fitu/CAD_TEST2/cad/cost_estimate.csv

item | quantity | unit_low_ILS | unit_high_ILS | total_low_ILS | total_high_ILS | note
bench_clamp_100mm | 2 | 25 | 55 | 50 | 110
bolt_M4x16 | 2 | 0.5 | 1.5 | 1.0 | 3.0
bolt_M4x20 | 2 | 0.5 | 1.5 | 1.0 | 3.0
bolt_M4x25 | 2 | 0.5 | 1.5 | 1.0 | 3.0
bolt_M5x20 | 8 | 0.6 | 2 | 4.8 | 16
bolt_M5x25 | 4 | 0.6 | 2 | 2.4 | 8
bolt_M5x40 | 2 | 0.6 | 2 | 1.2 | 4
bolt_M5x50 | 4 | 0.6 | 2 | 2.4 | 8
bolt_M6x30 | 2 | 0.8 | 2.5 | 1.6 | 5.0
bolt_M6x45 | 2 | 0.8 | 2.5 | 1.6 | 5.0
bolt_M8x25 | 1 | 1.5 | 4 | 1.5 | 4
firm_backing_and_protective_pads_set | 1 | 10 | 25 | 10 | 25
ground_dowel_6x30 | 2 | 3 | 10 | 6 | 20
ground_shaft_8x400 | 1 | 30 | 70 | 30 | 70
nut_M4 | 12 | 0.2 | 0.8 | 2.4 | 9.6
nut_M5 | 20 | 0.2 | 0.8 | 4.0 | 16.0
nut_M6 | 9 | 0.2 | 0.8 | 1.8 | 7.2
nut_M8 | 1 | 0.2 | 0.8 | 0.2 | 0.8
nylon_tip_screw_M4x8 | 4 | 2 | 6 | 8 | 24
set_screw_M4x16 | 2 | 0.6 | 2 | 1.2 | 4
stone_60x180x30 | 1 | 60 | 180 | 60 | 180 | optional if already owned
thin_nonmarring_blade_tape | 1 | 5 | 12 | 5 | 12
threaded_rod_M6x160_cut_from_stock | 1 | 8 | 20 | 8 | 20
washer_M4 | 2 | 0.1 | 0.5 | 0.2 | 1.0
washer_M5 | 8 | 0.1 | 0.5 | 0.8 | 4.0
washer_M6 | 10 | 0.1 | 0.5 | 1.0 | 5.0
washer_M8 | 2 | 0.1 | 0.5 | 0.2 | 1.0
spare_fasteners_and_pack_size_allowance | 1 | 10 | 25 | 10 | 25 | budget allowance
PETG_1kg_spool | 2 | 70 | 120 | 140 | 240 | whole spools; includes unused filament
