fitu/CAD_TEST2/cad/purchase_bom.csv

item | quantity
bench_clamp_100mm | 2
bolt_M4x16 | 2
bolt_M4x20 | 2
bolt_M4x25 | 2
bolt_M5x20 | 8
bolt_M5x25 | 4
bolt_M5x40 | 2
bolt_M5x50 | 4
bolt_M6x30 | 2
bolt_M6x45 | 2
bolt_M8x25 | 1
firm_backing_and_protective_pads_set | 1
ground_dowel_6x30 | 2
ground_shaft_8x400 | 1
nut_M4 | 12
nut_M5 | 20
nut_M6 | 9
nut_M8 | 1
nylon_tip_screw_M4x8 | 4
set_screw_M4x16 | 2
stone_60x180x30 | 1
thin_nonmarring_blade_tape | 1
threaded_rod_M6x160_cut_from_stock | 1
washer_M4 | 2
washer_M5 | 8
washer_M6 | 10
washer_M8 | 2
