fitu/CAD_TEST2/sharpener_assembly.step

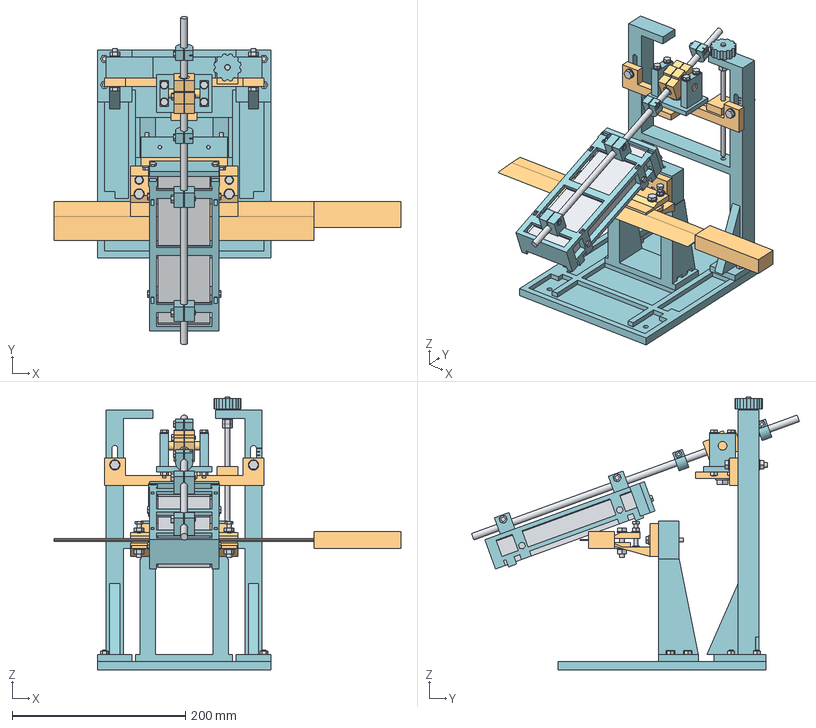
[picture p3: CAD file, 2026-11-03]
sharpener_assembly.step
400.0 x 378.6 x 315.0 mm
01_ribbed_bench_base
02_open_portal_frame
18_fine_height_knob
03_fixed_cartridge_dock
04_removable_knife_cartridge
05_upper_knife_jaw
06_blade_shim_3mm
REF_blade_envelope
REF_handle_envelope
05_height_carriage
06_yaw_plate
07_pitch_cheek_1
07_pitch_cheek_2
08_pitch_housing
09_calibrated_guide_sleeve
15_split_rod_stop_1
15_split_rod_stop_2
13_ribbed_stone_cassette
14_removable_end_gate
REF_whetstone
REF_stone_backing_1
REF_stone_backing_2
REF_stone_backing_3
REF_end_pad_fixed
REF_end_pad_gate
REF_side_pad_1
REF_side_pad_2
REF_side_pad_3
REF_side_pad_4
REF_guide_rod_8x400
HW_bolt_M5x20_1
HW_nut_M5_1
HW_bolt_M5x20_2
HW_nut_M5_2
HW_bolt_M5x20_3
HW_nut_M5_3
HW_bolt_M5x20_4
HW_nut_M5_4
HW_threaded_rod_M6x160_cut_from_stock_1
HW_nut_M6_1
HW_nut_M6_2
HW_washer_M6_1
HW_washer_M6_2
HW_nut_M6_3
HW_nut_M6_4
HW_bolt_M5x20_5
HW_nut_M5_5
HW_bolt_M5x20_6
HW_nut_M5_6
HW_bolt_M5x20_7
HW_nut_M5_7
HW_bolt_M5x20_8
HW_nut_M5_8
HW_ground_dowel_6x30_1
HW_set_screw_M4x16_1
HW_nut_M4_1
HW_ground_dowel_6x30_2
HW_set_screw_M4x16_2
HW_nut_M4_2
HW_bolt_M5x40_1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
