fitu/CAD_TEST2/parts/03_fixed_cartridge_dock.step

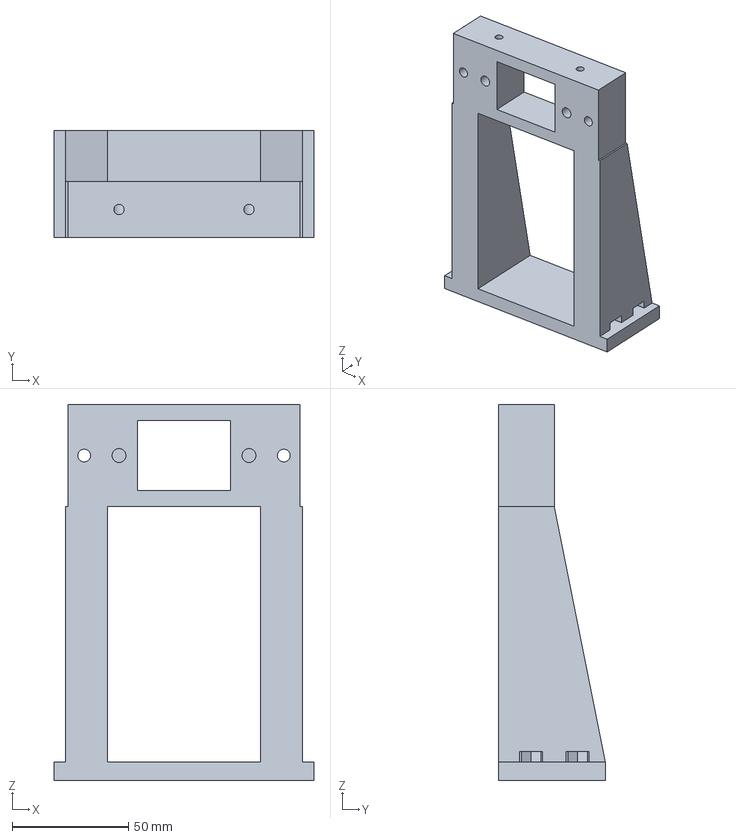
[picture p4: CAD file, 2026-11-03]
parts/03_fixed_cartridge_dock.step
112.0 x 46.0 x 162.0 mm
