fitu/CAD_TEST2/parts/05_height_carriage.step

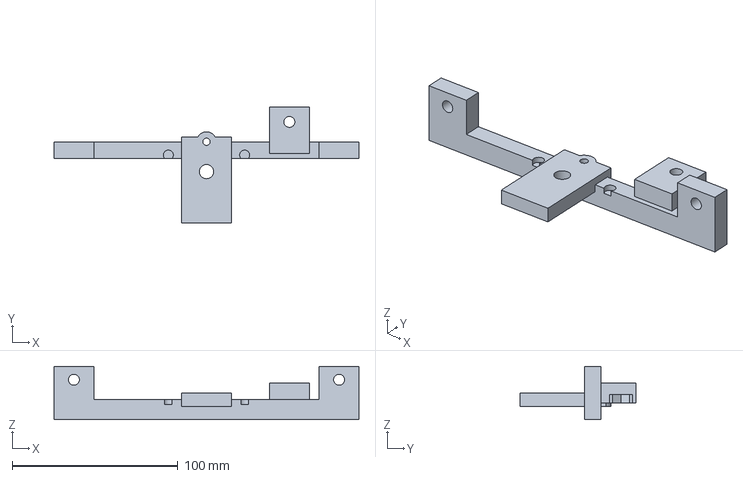
[picture p5: CAD file, 2026-11-03]
parts/05_height_carriage.step
184.0 x 70.0 x 32.0 mm
