fitu/CAD_TEST2/parts/REF_whetstone.step

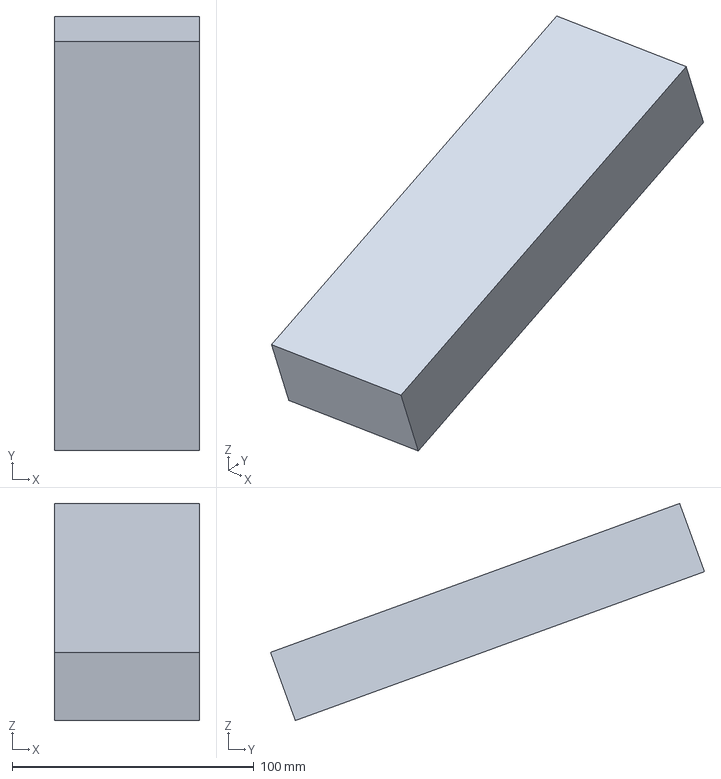
[picture p6: CAD file, 2026-11-03]
parts/REF_whetstone.step
60.0 x 179.4 x 89.8 mm
