fitu/CAD_TEST2/parts/REF_side_pad_2.step

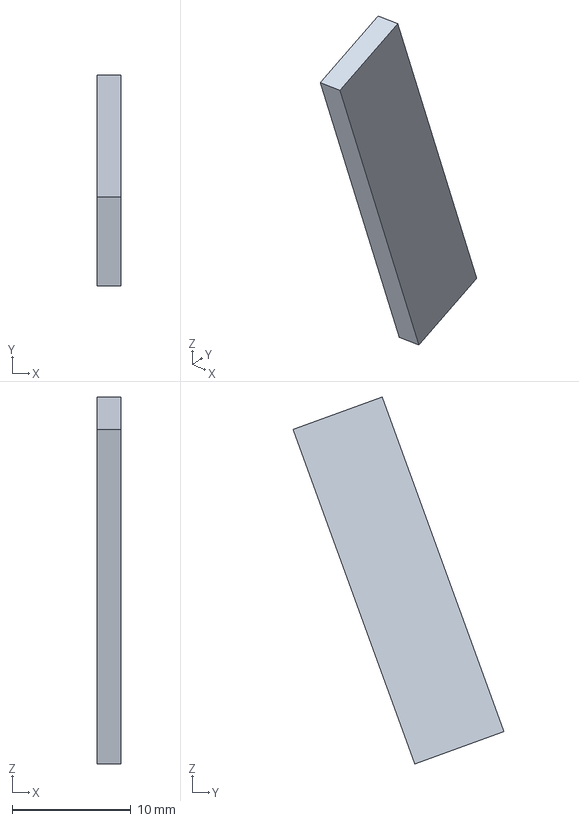
[picture p7: CAD file, 2026-11-03]
parts/REF_side_pad_2.step
2.00 x 17.8 x 30.9 mm
