fitu/CAD_TEST2/parts/07_pitch_cheek_1.step

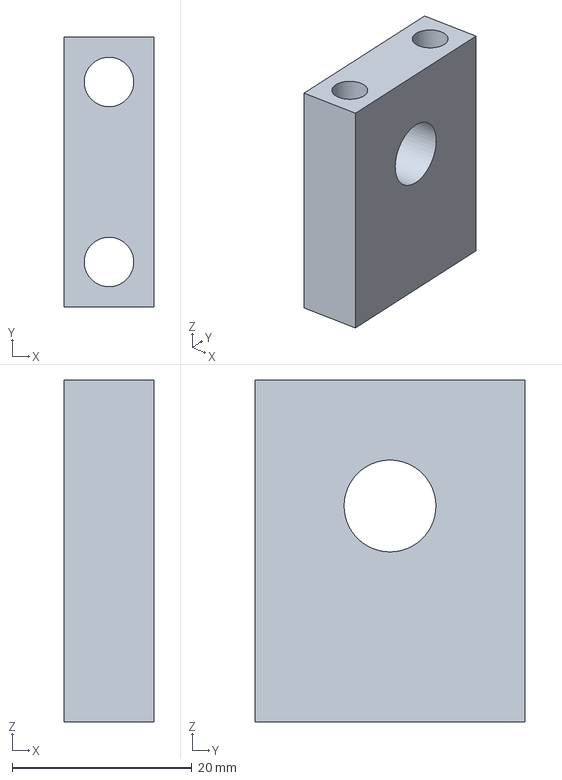
[picture p8: CAD file, 2026-11-03]
parts/07_pitch_cheek_1.step
10.0 x 30.0 x 38.0 mm
