fitu/CAD_TEST2/parts/15_split_rod_stop_2.step

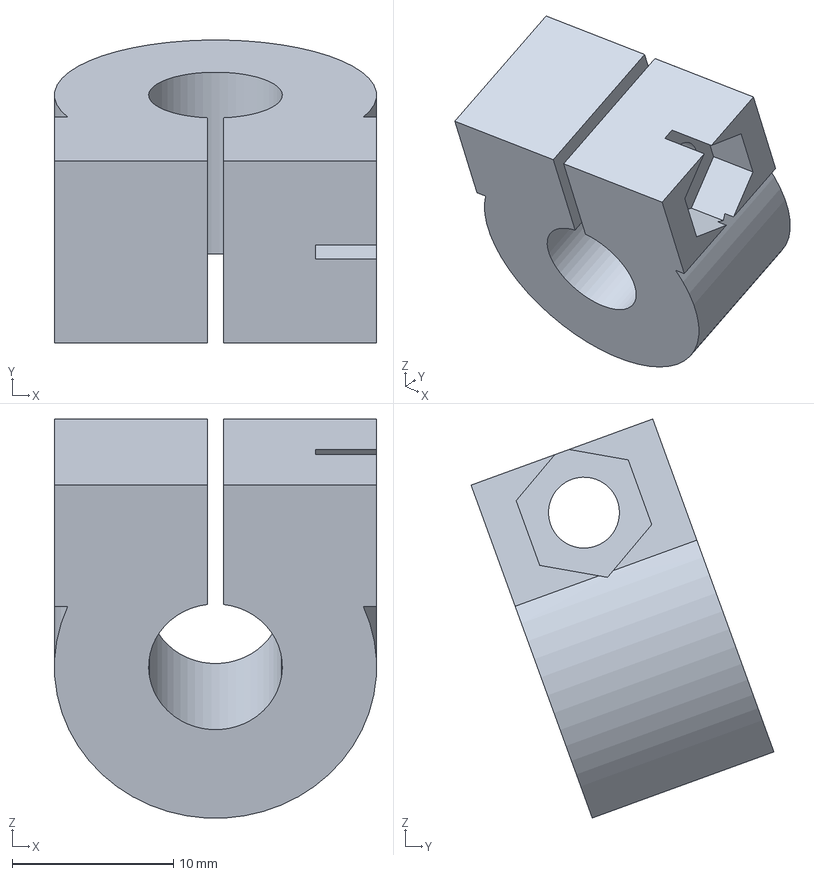
[picture p9: CAD file, 2026-11-03]
parts/15_split_rod_stop_2.step
20.0 x 18.8 x 24.8 mm
