fitu/CAD_TEST2/parts/REF_stone_backing_1.step

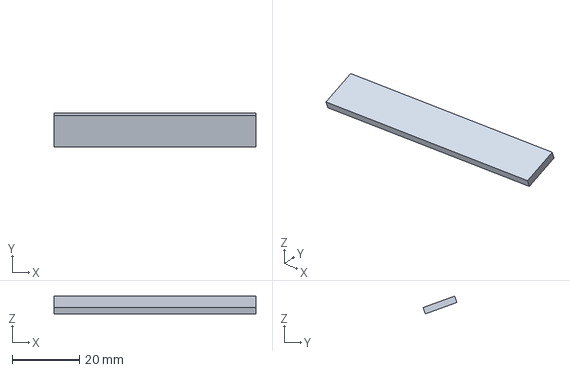
[picture p10: CAD file, 2026-11-03]
parts/REF_stone_backing_1.step
60.0 x 10.1 x 5.30 mm
