fitu/CAD_TEST2/parts/REF_end_pad_fixed.step

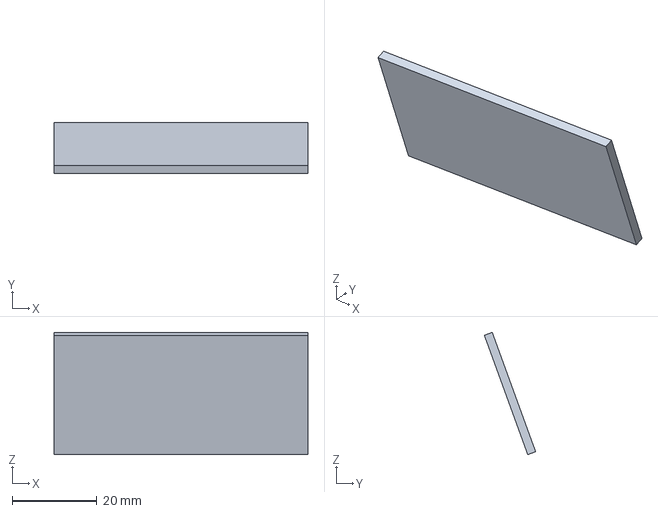
[picture p11: CAD file, 2026-11-03]
parts/REF_end_pad_fixed.step
60.0 x 12.1 x 28.9 mm
