fitu/CAD_TEST2/hardware/shaft_M6x160.step

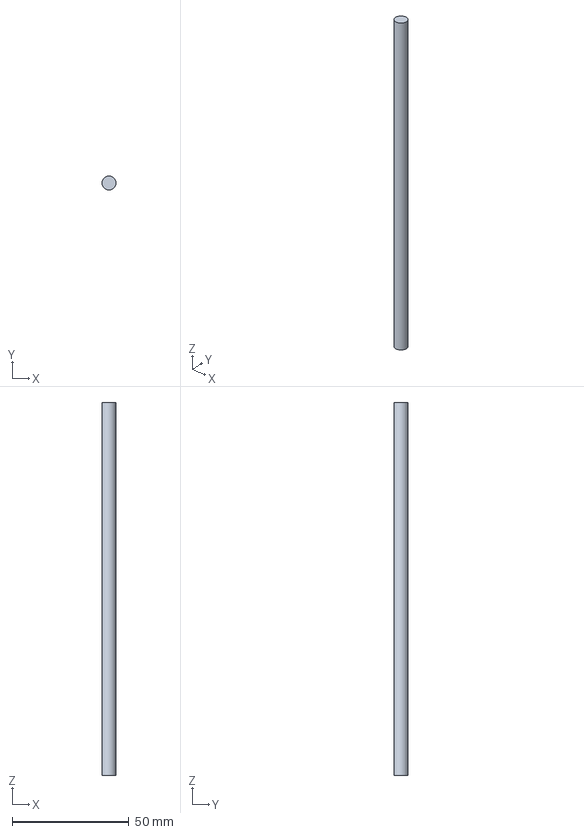
[picture p12: CAD file, 2026-11-03]
hardware/shaft_M6x160.step
5.99 x 6.00 x 160.0 mm
