fitu/CAD_TEST2/parts/OPTION_blade_shim_for_4mm.step

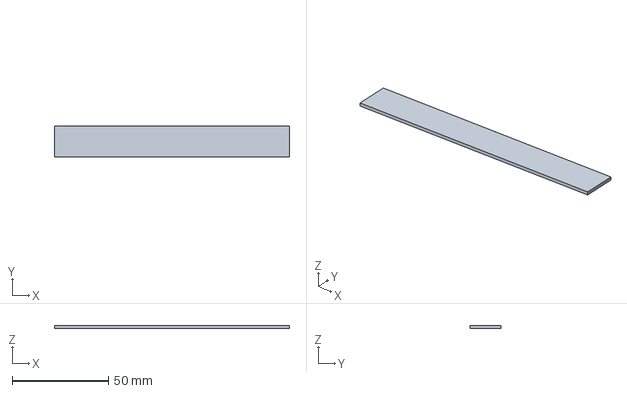
[picture p13: CAD file, 2026-11-03]
parts/OPTION_blade_shim_for_4mm.step
122.0 x 16.0 x 1.50 mm
