fitu/CAD_TEST2/parts/02_open_portal_frame.step

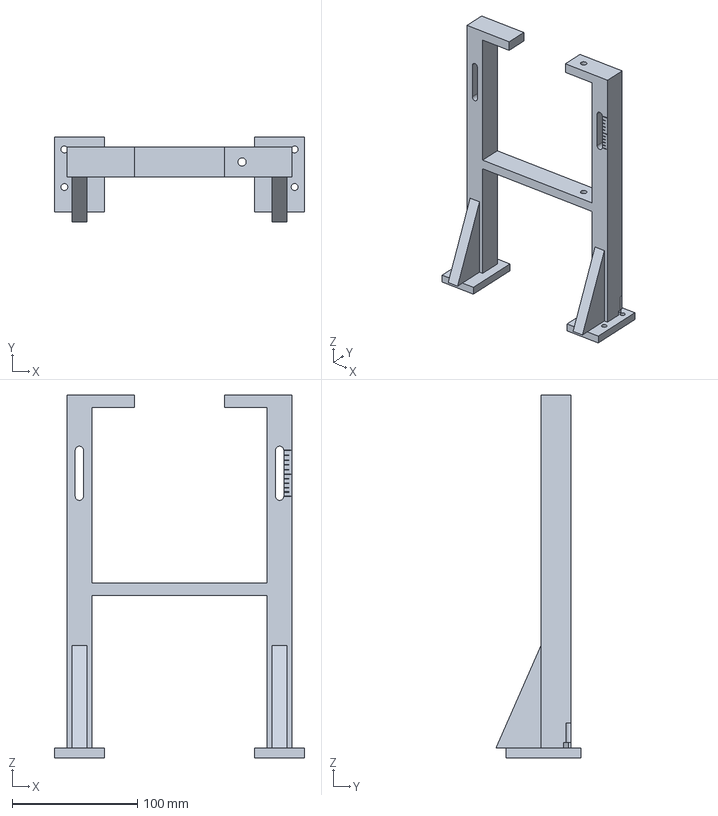
[picture p14: CAD file, 2026-11-03]
parts/02_open_portal_frame.step
200.0 x 68.0 x 290.0 mm
