fitu/CAD_TEST2/parts/06_blade_shim_3mm.step

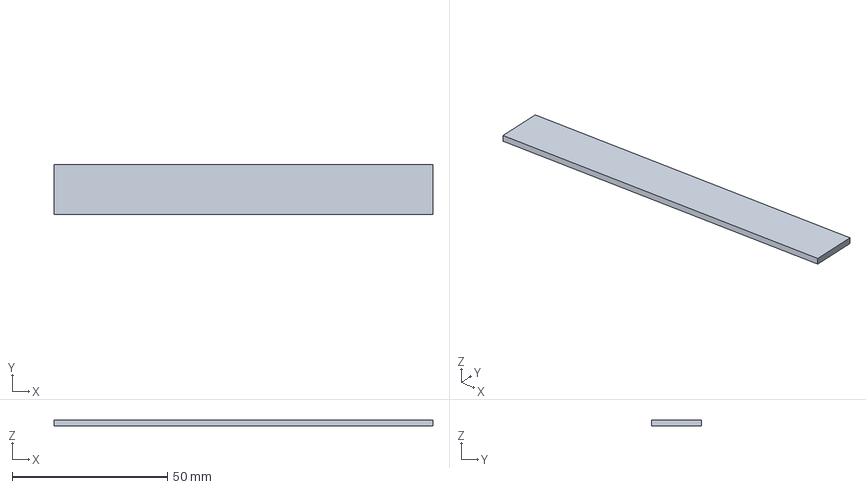
[picture p15: CAD file, 2026-11-03]
parts/06_blade_shim_3mm.step
122.0 x 16.0 x 2.00 mm
