fitu/CAD_TEST2/parts/06_yaw_plate.step

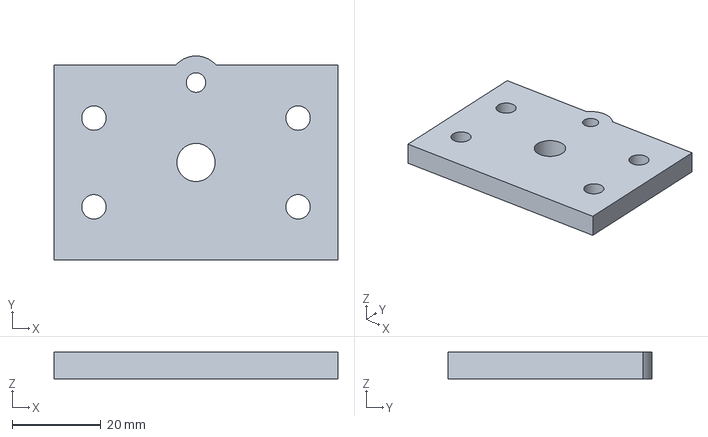
[picture p16: CAD file, 2026-11-03]
parts/06_yaw_plate.step
64.0 x 46.0 x 6.00 mm
