fitu/CAD_TEST2/parts/01_ribbed_bench_base.step

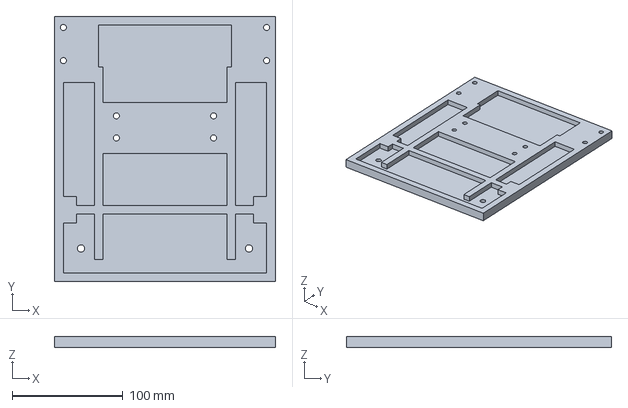
[picture p17: CAD file, 2026-11-03]
parts/01_ribbed_bench_base.step
200.0 x 240.0 x 10.0 mm
