fitu/CAD_TEST2/parts/18_fine_height_knob.step

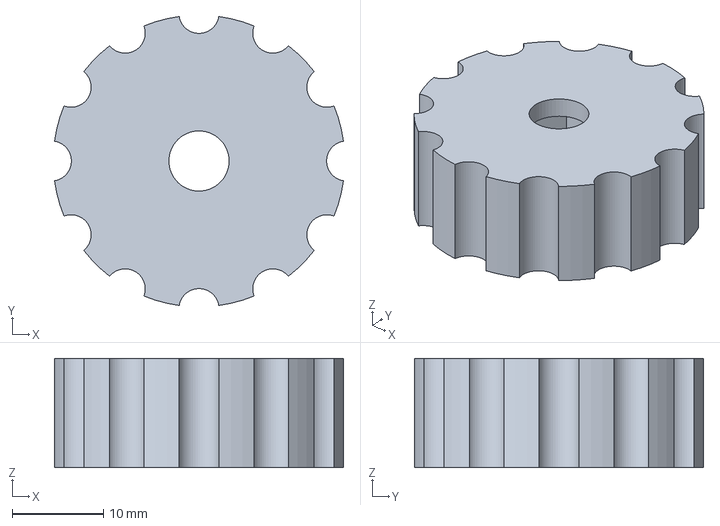
[picture p18: CAD file, 2026-11-03]
parts/18_fine_height_knob.step
31.7 x 31.7 x 12.0 mm
