fitu/CAD_TEST2/parts/04_removable_knife_cartridge.step

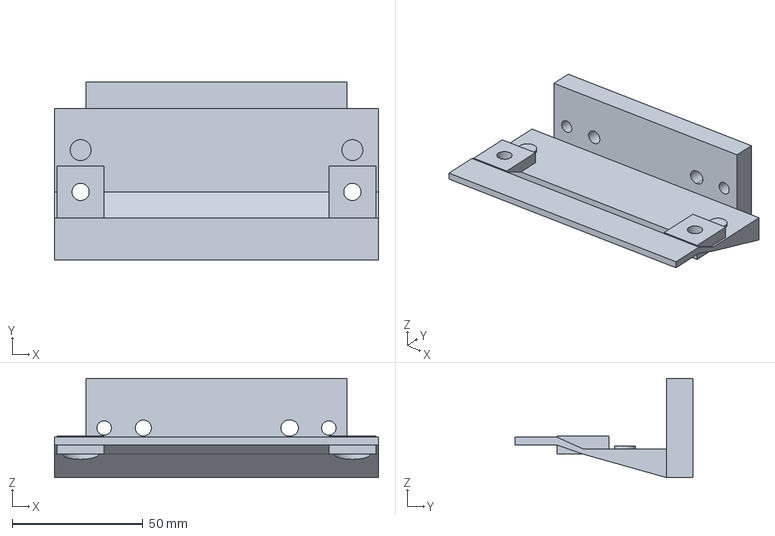
[picture p19: CAD file, 2026-11-03]
parts/04_removable_knife_cartridge.step
124.0 x 68.0 x 38.0 mm
