fitu/CAD_TEST2/hardware/dowel_M6x30.step

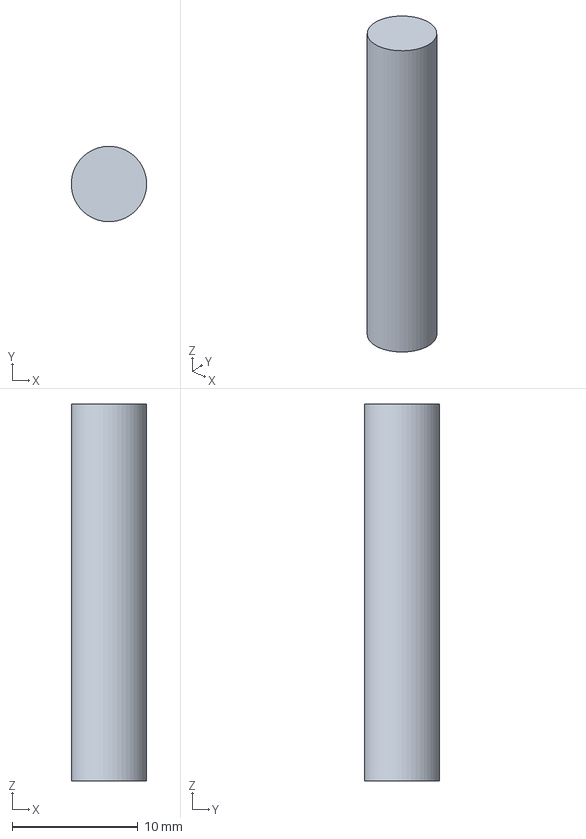
[picture p20: CAD file, 2026-11-03]
hardware/dowel_M6x30.step
5.99 x 6.00 x 30.0 mm
