fitu/CAD_TEST2/parts/OPTION_blade_shim_for_5mm.step

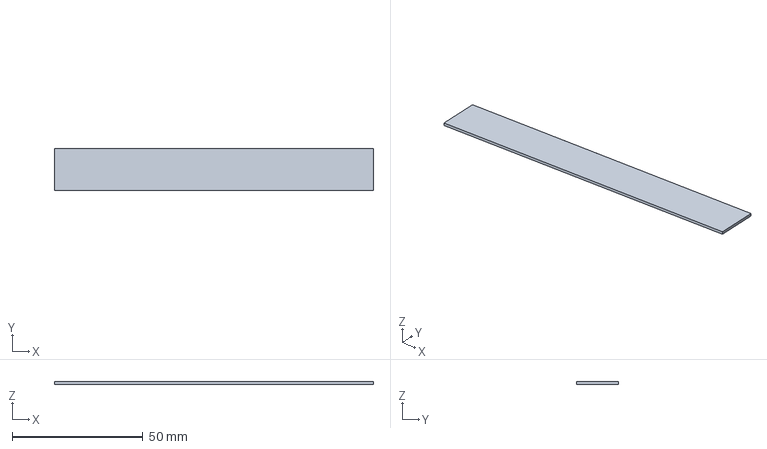
[picture p21: CAD file, 2026-11-03]
parts/OPTION_blade_shim_for_5mm.step
122.0 x 16.0 x 1.00 mm
