fitu/CAD_TEST2/parts/13_ribbed_stone_cassette.step

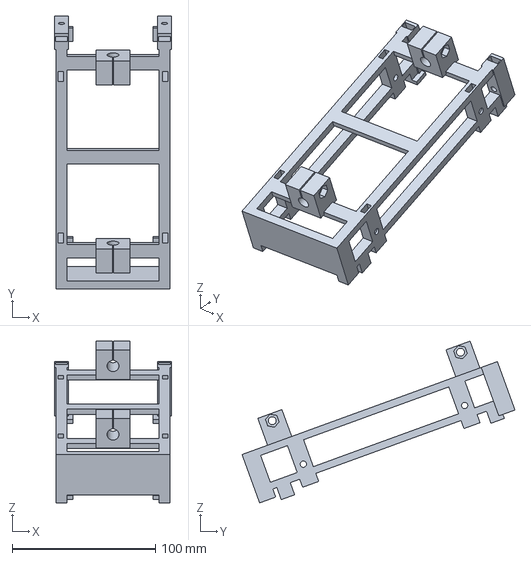
[picture p22: CAD file, 2026-11-03]
parts/13_ribbed_stone_cassette.step
82.0 x 190.9 x 113.2 mm
