fitu/CAD_TEST2/parts/REF_handle_envelope.step

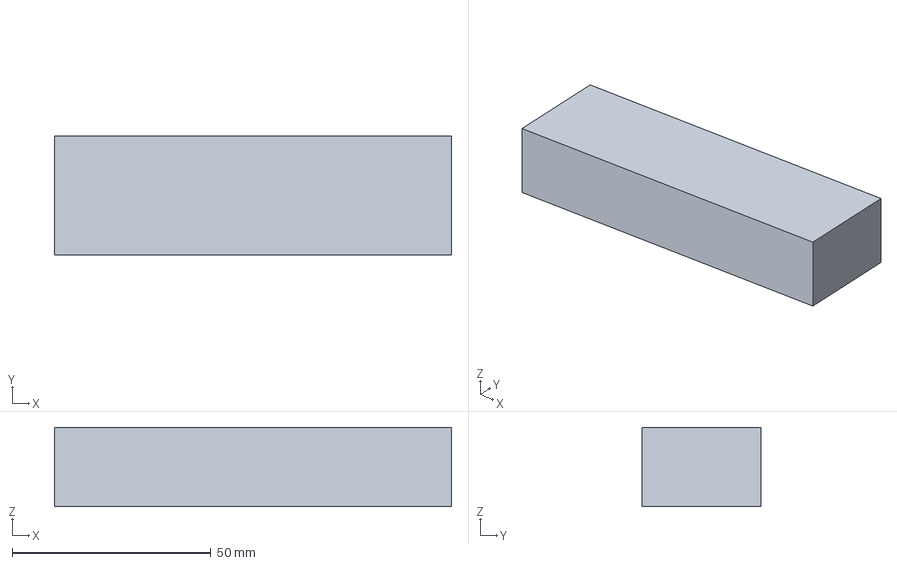
[picture p23: CAD file, 2026-11-03]
parts/REF_handle_envelope.step
100.0 x 30.0 x 20.0 mm
