fitu/CAD_TEST2/parts/SETUP_28mm_protrusion_gauge.step

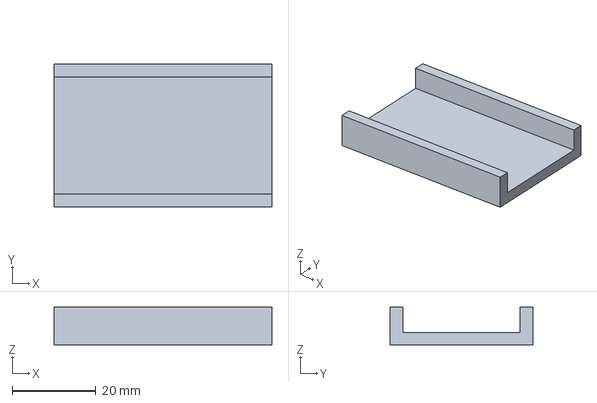
[picture p24: CAD file, 2026-11-03]
parts/SETUP_28mm_protrusion_gauge.step
52.0 x 34.0 x 9.00 mm
