fitu/CAD_TEST2/parts/OPTION_blade_shim_for_6mm.step

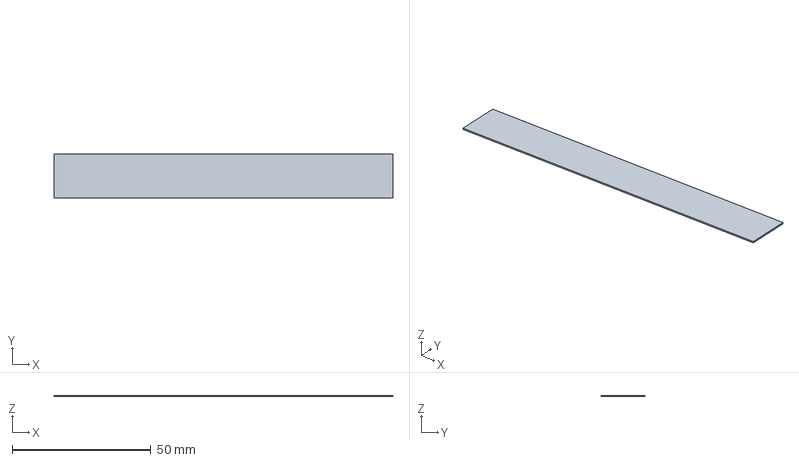
[picture p25: CAD file, 2026-11-03]
parts/OPTION_blade_shim_for_6mm.step
122.0 x 16.0 x 0.5 mm
