fitu/CAD_TEST2/parts/09_calibrated_guide_sleeve.step

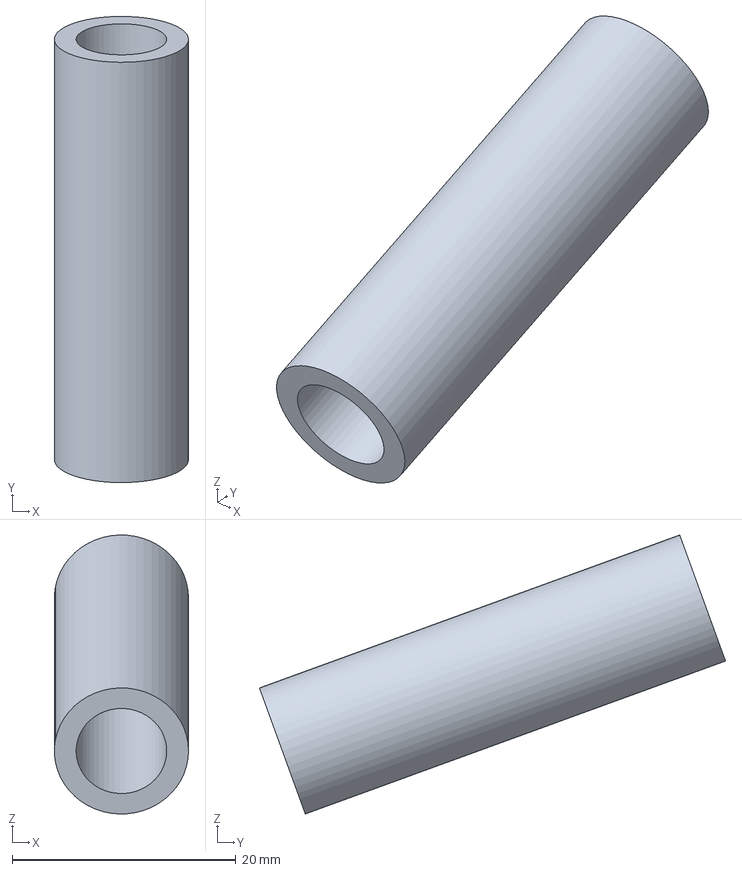
[picture p26: CAD file, 2026-11-03]
parts/09_calibrated_guide_sleeve.step
12.0 x 41.7 x 25.0 mm
