fitu/CAD_TEST2/parts/COUPON_bearing_and_dowel_fits.step

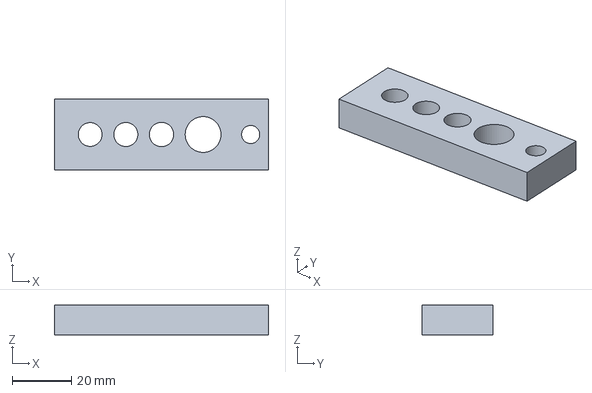
[picture p27: CAD file, 2026-11-03]
parts/COUPON_bearing_and_dowel_fits.step
72.0 x 24.0 x 10.0 mm
