fitu/CAD_TEST2/parts/REF_guide_rod_8x400.step

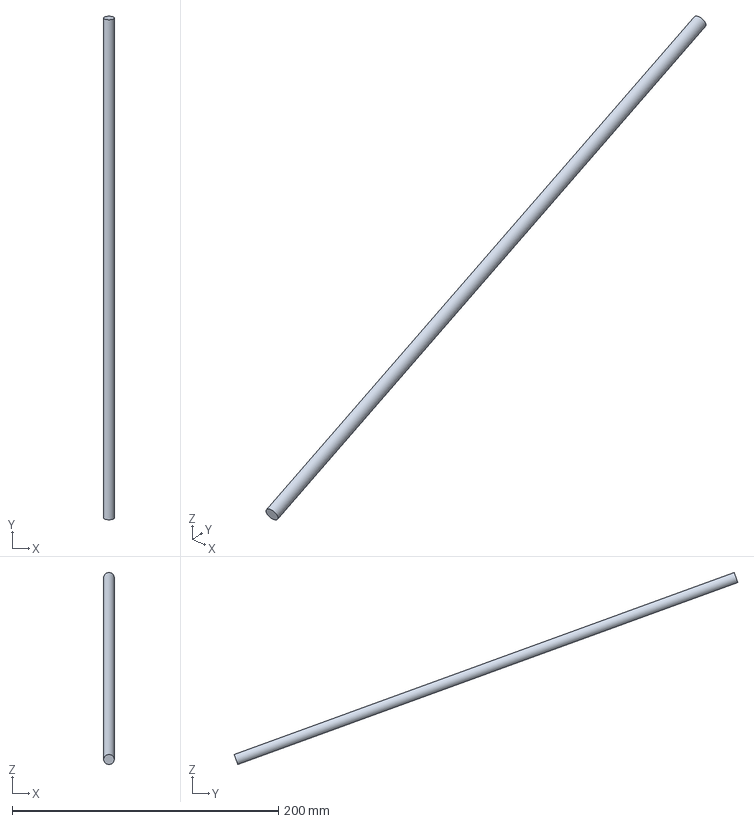
[picture p28: CAD file, 2026-11-03]
parts/REF_guide_rod_8x400.step
7.99 x 378.6 x 144.3 mm
