fitu/CAD_TEST2/parts/REF_blade_envelope.step

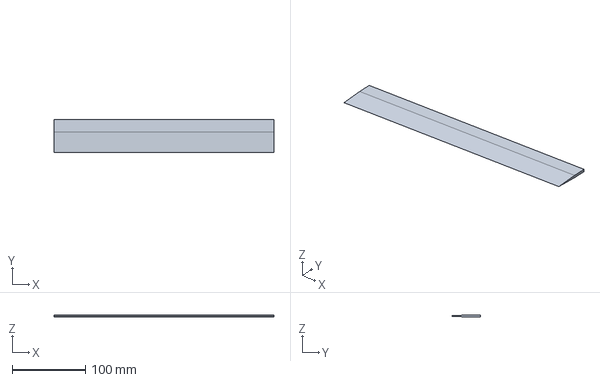
[picture p29: CAD file, 2026-11-03]
parts/REF_blade_envelope.step
300.0 x 45.0 x 3.00 mm
