fitu/CAD_TEST2/parts/OPTION_blade_shim_for_1mm.step

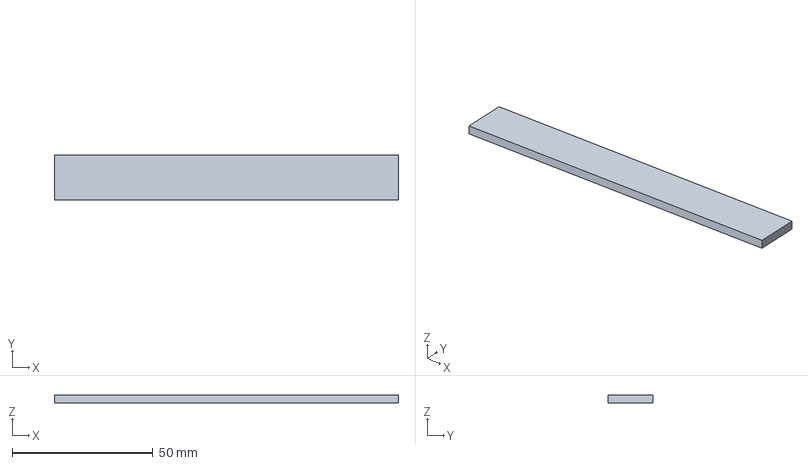
[picture p30: CAD file, 2026-11-03]
parts/OPTION_blade_shim_for_1mm.step
122.0 x 16.0 x 3.00 mm
