fitu/CAD_TEST2/parts/08_pitch_housing.step

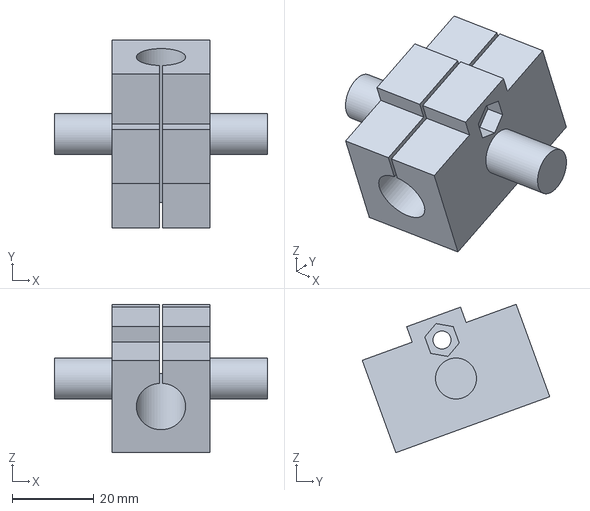
[picture p31: CAD file, 2026-11-03]
parts/08_pitch_housing.step
52.0 x 45.8 x 36.2 mm
