fitu/CAD_TEST2/parts/14_removable_end_gate.step

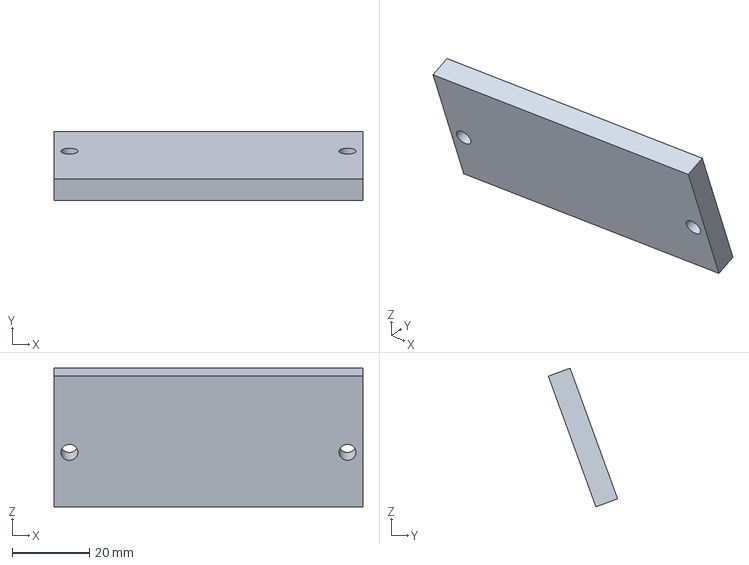
[picture p32: CAD file, 2026-11-03]
parts/14_removable_end_gate.step
80.0 x 18.0 x 35.9 mm
