fitu/CAD_TEST2/parts/OPTION_blade_shim_for_2mm.step

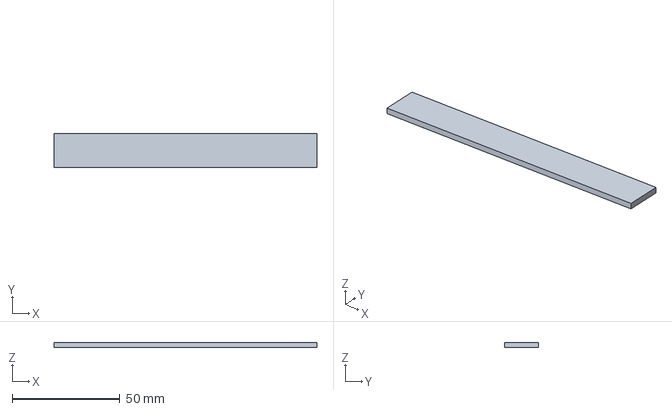
[picture p33: CAD file, 2026-11-03]
parts/OPTION_blade_shim_for_2mm.step
122.0 x 16.0 x 2.50 mm
