fitu/CAD_TEST2/parts/05_upper_knife_jaw.step

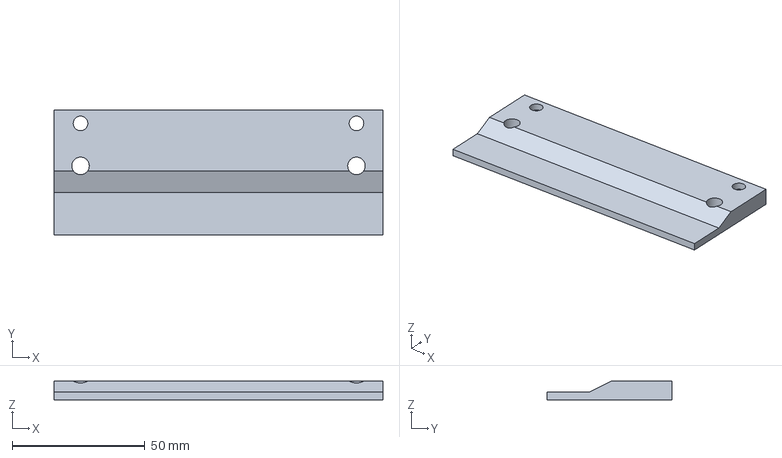
[picture p34: CAD file, 2026-11-03]
parts/05_upper_knife_jaw.step
124.0 x 47.0 x 7.00 mm
