fitu/CAD_TEST2/(list of files, cad)

Other CAD files:
parts/15_split_rod_stop_1.step
parts/REF_stone_backing_3.step
parts/REF_side_pad_3.step
assembly_parts/REF_end_pad_gate.step
parts/REF_stone_backing_2.step
assembly_parts/HW_threaded_rod_M6x160_cut_from_stock_1.step
assembly_parts/07_pitch_cheek_2.step
parts/REF_side_pad_4.step
parts/07_pitch_cheek_2.step
parts/REF_side_pad_1.step
parts/REF_end_pad_gate.step
assembly_parts/REF_side_pad_3.step
assembly_parts/REF_stone_backing_2.step
assembly_parts/HW_ground_dowel_6x30_2.step
assembly_parts/HW_ground_dowel_6x30_1.step
assembly_parts/REF_stone_backing_3.step
assembly_parts/REF_side_pad_4.step
assembly_parts/15_split_rod_stop_1.step
assembly_parts/REF_side_pad_1.step
assembly_parts/HW_bolt_M4x16_1.step
assembly_parts/HW_bolt_M4x16_2.step
assembly_parts/HW_bolt_M4x20_1.step
assembly_parts/HW_bolt_M4x20_2.step
assembly_parts/HW_bolt_M4x25_1.step
assembly_parts/HW_bolt_M4x25_2.step
assembly_parts/HW_bolt_M5x20_1.step
assembly_parts/HW_bolt_M5x20_2.step
assembly_parts/HW_bolt_M5x20_3.step
assembly_parts/HW_bolt_M5x20_4.step
assembly_parts/HW_bolt_M5x20_5.step
assembly_parts/HW_bolt_M5x20_6.step
assembly_parts/HW_bolt_M5x20_7.step
assembly_parts/HW_bolt_M5x20_8.step
assembly_parts/HW_bolt_M5x25_1.step
assembly_parts/HW_bolt_M5x25_2.step
assembly_parts/HW_bolt_M5x25_3.step
assembly_parts/HW_bolt_M5x25_4.step
assembly_parts/HW_bolt_M5x40_1.step
assembly_parts/HW_bolt_M5x40_2.step
assembly_parts/HW_bolt_M5x50_1.step
assembly_parts/HW_bolt_M5x50_2.step
assembly_parts/HW_bolt_M5x50_3.step
assembly_parts/HW_bolt_M5x50_4.step
assembly_parts/HW_bolt_M6x30_1.step
assembly_parts/HW_bolt_M6x30_2.step
assembly_parts/HW_bolt_M6x45_1.step
assembly_parts/HW_bolt_M6x45_2.step
assembly_parts/HW_bolt_M8x25_1.step
assembly_parts/HW_nut_M4_1.step
assembly_parts/HW_nut_M4_10.step
assembly_parts/HW_nut_M4_11.step
assembly_parts/HW_nut_M4_12.step
assembly_parts/HW_nut_M4_2.step
assembly_parts/HW_nut_M4_3.step
assembly_parts/HW_nut_M4_4.step
assembly_parts/HW_nut_M4_5.step
assembly_parts/HW_nut_M4_6.step
assembly_parts/HW_nut_M4_7.step
assembly_parts/HW_nut_M4_8.step
assembly_parts/HW_nut_M4_9.step
assembly_parts/HW_nut_M5_1.step
assembly_parts/HW_nut_M5_10.step
assembly_parts/HW_nut_M5_11.step
assembly_parts/HW_nut_M5_12.step
assembly_parts/HW_nut_M5_13.step
assembly_parts/HW_nut_M5_14.step
assembly_parts/HW_nut_M5_15.step
assembly_parts/HW_nut_M5_16.step
assembly_parts/HW_nut_M5_17.step
assembly_parts/HW_nut_M5_18.step
assembly_parts/HW_nut_M5_19.step
assembly_parts/HW_nut_M5_2.step
assembly_parts/HW_nut_M5_20.step
assembly_parts/HW_nut_M5_3.step
assembly_parts/HW_nut_M5_4.step
assembly_parts/HW_nut_M5_5.step
assembly_parts/HW_nut_M5_6.step
assembly_parts/HW_nut_M5_7.step
assembly_parts/HW_nut_M5_8.step
assembly_parts/HW_nut_M5_9.step
assembly_parts/HW_nut_M6_1.step
assembly_parts/HW_nut_M6_2.step
assembly_parts/HW_nut_M6_3.step
assembly_parts/HW_nut_M6_4.step
assembly_parts/HW_nut_M6_5.step
assembly_parts/HW_nut_M6_6.step
assembly_parts/HW_nut_M6_7.step
assembly_parts/HW_nut_M6_8.step
assembly_parts/HW_nut_M6_9.step
assembly_parts/HW_nut_M8_1.step
assembly_parts/HW_nylon_tip_screw_M4x8_1.step
assembly_parts/HW_nylon_tip_screw_M4x8_2.step
assembly_parts/HW_nylon_tip_screw_M4x8_3.step
assembly_parts/HW_nylon_tip_screw_M4x8_4.step
assembly_parts/HW_set_screw_M4x16_1.step
assembly_parts/HW_set_screw_M4x16_2.step
assembly_parts/HW_washer_M4_1.step
assembly_parts/HW_washer_M4_2.step
assembly_parts/HW_washer_M5_1.step
assembly_parts/HW_washer_M5_2.step
assembly_parts/HW_washer_M5_3.step
assembly_parts/HW_washer_M5_4.step
assembly_parts/HW_washer_M5_5.step
assembly_parts/HW_washer_M5_6.step
assembly_parts/HW_washer_M5_7.step
assembly_parts/HW_washer_M5_8.step
assembly_parts/HW_washer_M6_1.step
assembly_parts/HW_washer_M6_10.step
assembly_parts/HW_washer_M6_2.step
assembly_parts/HW_washer_M6_3.step
assembly_parts/HW_washer_M6_4.step
assembly_parts/HW_washer_M6_5.step
assembly_parts/HW_washer_M6_6.step
assembly_parts/HW_washer_M6_7.step
assembly_parts/HW_washer_M6_8.step
assembly_parts/HW_washer_M6_9.step
assembly_parts/HW_washer_M8_1.step
assembly_parts/HW_washer_M8_2.step
hardware/bolt_M4x16.step
hardware/bolt_M4x20.step
hardware/bolt_M4x25.step
hardware/bolt_M4x8.step
hardware/bolt_M5x20.step
hardware/bolt_M5x25.step
hardware/bolt_M5x40.step
hardware/bolt_M5x50.step
hardware/bolt_M6x30.step
hardware/bolt_M6x45.step
hardware/bolt_M8x25.step
hardware/nut_M4.step
hardware/nut_M5.step
hardware/nut_M6.step
hardware/nut_M8.step
hardware/set_screw_M4x16.step
hardware/washer_M4.step
hardware/washer_M5.step
hardware/washer_M6.step
hardware/washer_M8.step
print/01_ribbed_bench_base.step
print/01_ribbed_bench_base.stl
print/02_open_portal_frame.step
print/02_open_portal_frame.stl
print/03_fixed_cartridge_dock.step
print/03_fixed_cartridge_dock.stl
print/04_removable_knife_cartridge.step
print/04_removable_knife_cartridge.stl
print/05_height_carriage.step
print/05_height_carriage.stl
print/05_upper_knife_jaw.step
print/05_upper_knife_jaw.stl
print/06_blade_shim_3mm.step
print/06_blade_shim_3mm.stl
print/06_yaw_plate.step
print/06_yaw_plate.stl
print/07_pitch_cheek_1.step
print/07_pitch_cheek_1.stl
print/07_pitch_cheek_2.step
print/07_pitch_cheek_2.stl
print/08_pitch_housing.step
print/08_pitch_housing.stl
print/09_calibrated_guide_sleeve.step
print/09_calibrated_guide_sleeve.stl
print/13_ribbed_stone_cassette.step
print/13_ribbed_stone_cassette.stl
print/14_removable_end_gate.step
print/14_removable_end_gate.stl
print/15_split_rod_stop_1.step
print/15_split_rod_stop_1.stl
print/15_split_rod_stop_2.step
print/15_split_rod_stop_2.stl
print/18_fine_height_knob.step
print/18_fine_height_knob.stl
print/COUPON_bearing_and_dowel_fits.step
print/COUPON_bearing_and_dowel_fits.stl
print/OPTION_blade_shim_for_1mm.step
print/OPTION_blade_shim_for_1mm.stl
print/OPTION_blade_shim_for_2mm.step
print/OPTION_blade_shim_for_2mm.stl
print/OPTION_blade_shim_for_4mm.step
print/OPTION_blade_shim_for_4mm.stl
print/OPTION_blade_shim_for_5mm.step
print/OPTION_blade_shim_for_5mm.stl
print/OPTION_blade_shim_for_6mm.step
print/OPTION_blade_shim_for_6mm.stl
print/SETUP_28mm_protrusion_gauge.step
print/SETUP_28mm_protrusion_gauge.stl
