fitu/CAD_TEST2/(commit log)

2026-10-30 Add guided knife sharpener prototype CAD and assembly instructions
    [01_ballast_base.step, 02_structural_lid.step, 03_pedestal_1.step, 03_pedestal_2.step, 04_rotor_lower_jaw.step, 05_upper_jaw.step, 06_half_turn_disc.step, 07_stop_bridge.step]
2026-11-03 Redesign sharpener as compact bench-mounted revision B
    [01_ballast_base.step, 01_ribbed_bench_base.step, 01_ribbed_bench_base.stl, 02_open_portal_frame.step, 02_open_portal_frame.stl, 02_structural_lid.step, 03_fixed_cartridge_dock.step, 03_fixed_cartridge_dock.stl]
